xavier-phillips/exoARM/cad/README.md

# CAD Files

Mechanical components for the exoARM were designed in Autodesk Inventor. The original CAD files have been lost and are no longer available.

Design screenshots and renders from the original folio are included in the project [README](../README.md) and the [full folio PDF](../docs/exoARM_Folio_Full.pdf).
